eegan/albatross_fee/new-fee.kicad_pcb

## KiCad design new-fee.kicad_pcb (2023-12-21)

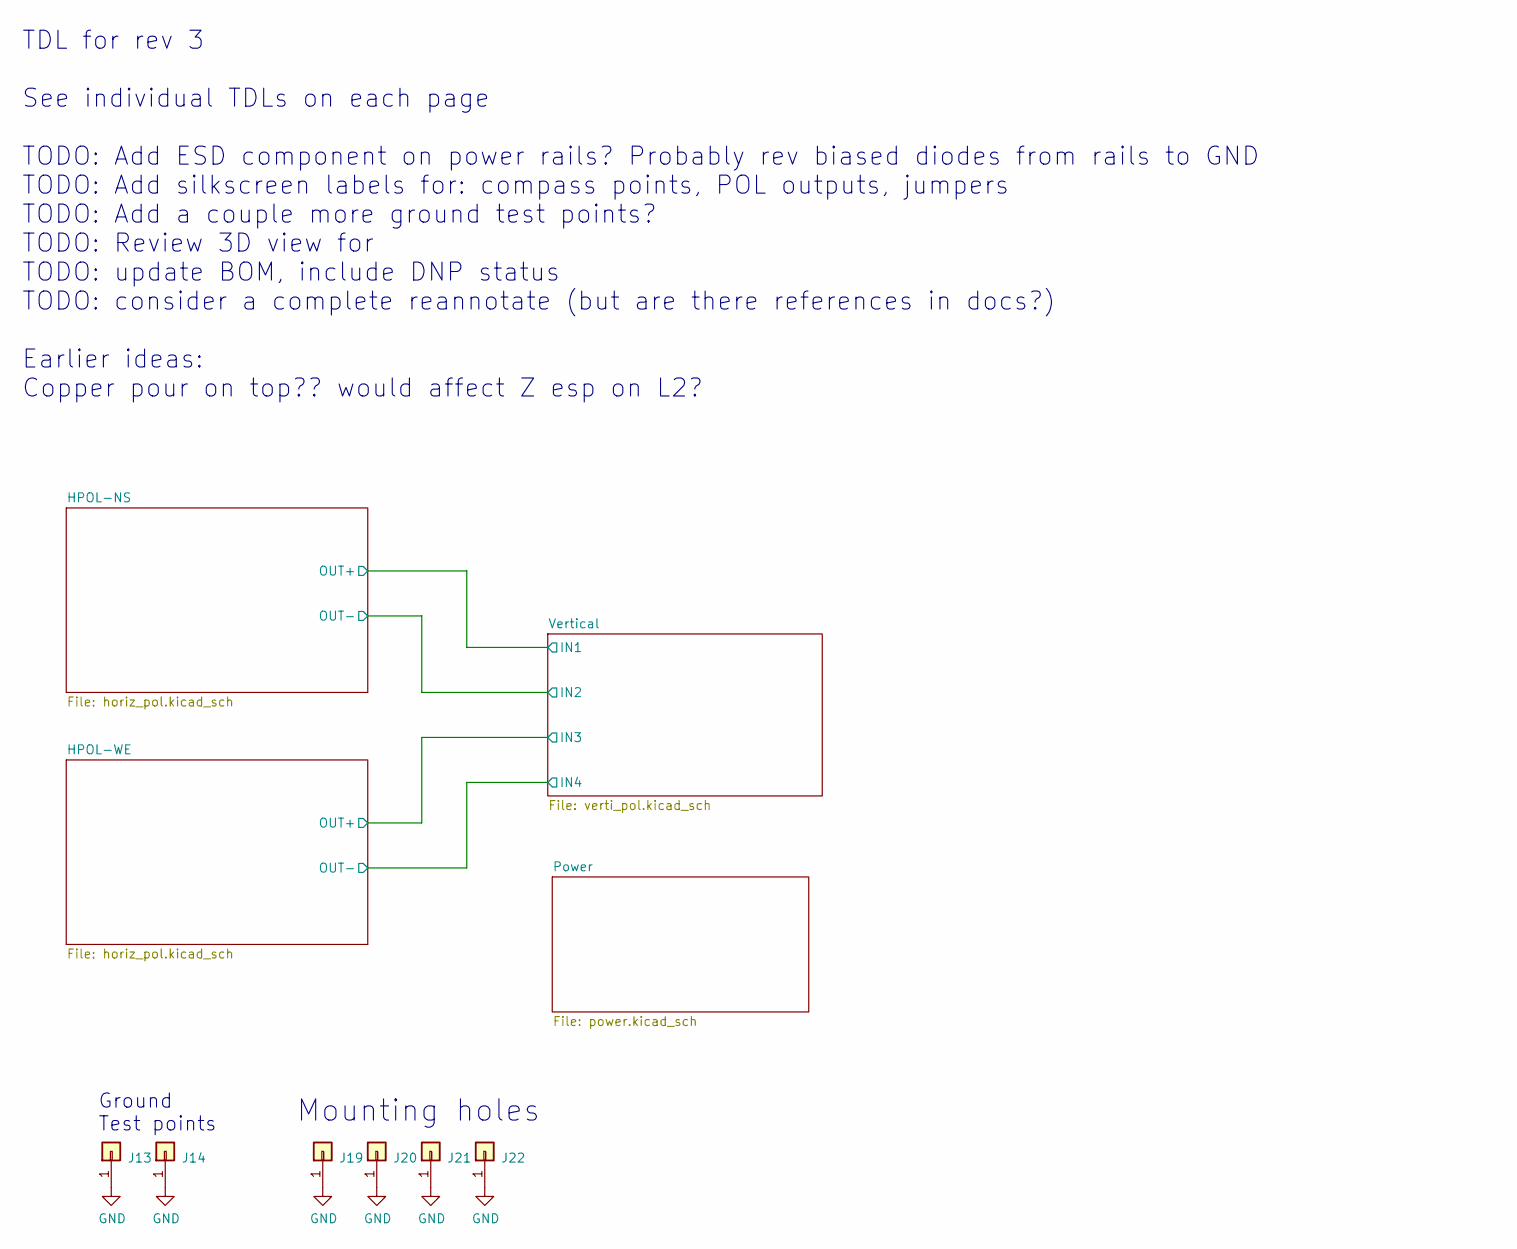
[picture p1: schematic new-fee.kicad_sch, ALBATROS low frequency front end]

Parts:
J13, J14: Conn_01x01; PinHeader_1x01_P2.54mm_Vertical
J19, J20, J21, J22: Conn_01x01; MountingHole_2.7mm_M2.5_Pad

Connections:
GND: J13.1, J14.1, J19.1, J20.1, J21.1, J22.1; also elsewhere on the board

Notes on the sheet:
Mounting holes
TDL for rev 3 See individual TDLs on each page TODO: Add ESD component on power rails? Probably rev biased diodes from rails to GND TODO: Add silkscreen labels for: compass points, POL outputs, jumpers TODO: Add a couple more ground test points? TODO: Review 3D view for TODO: update BOM, include DN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
Ground Test points

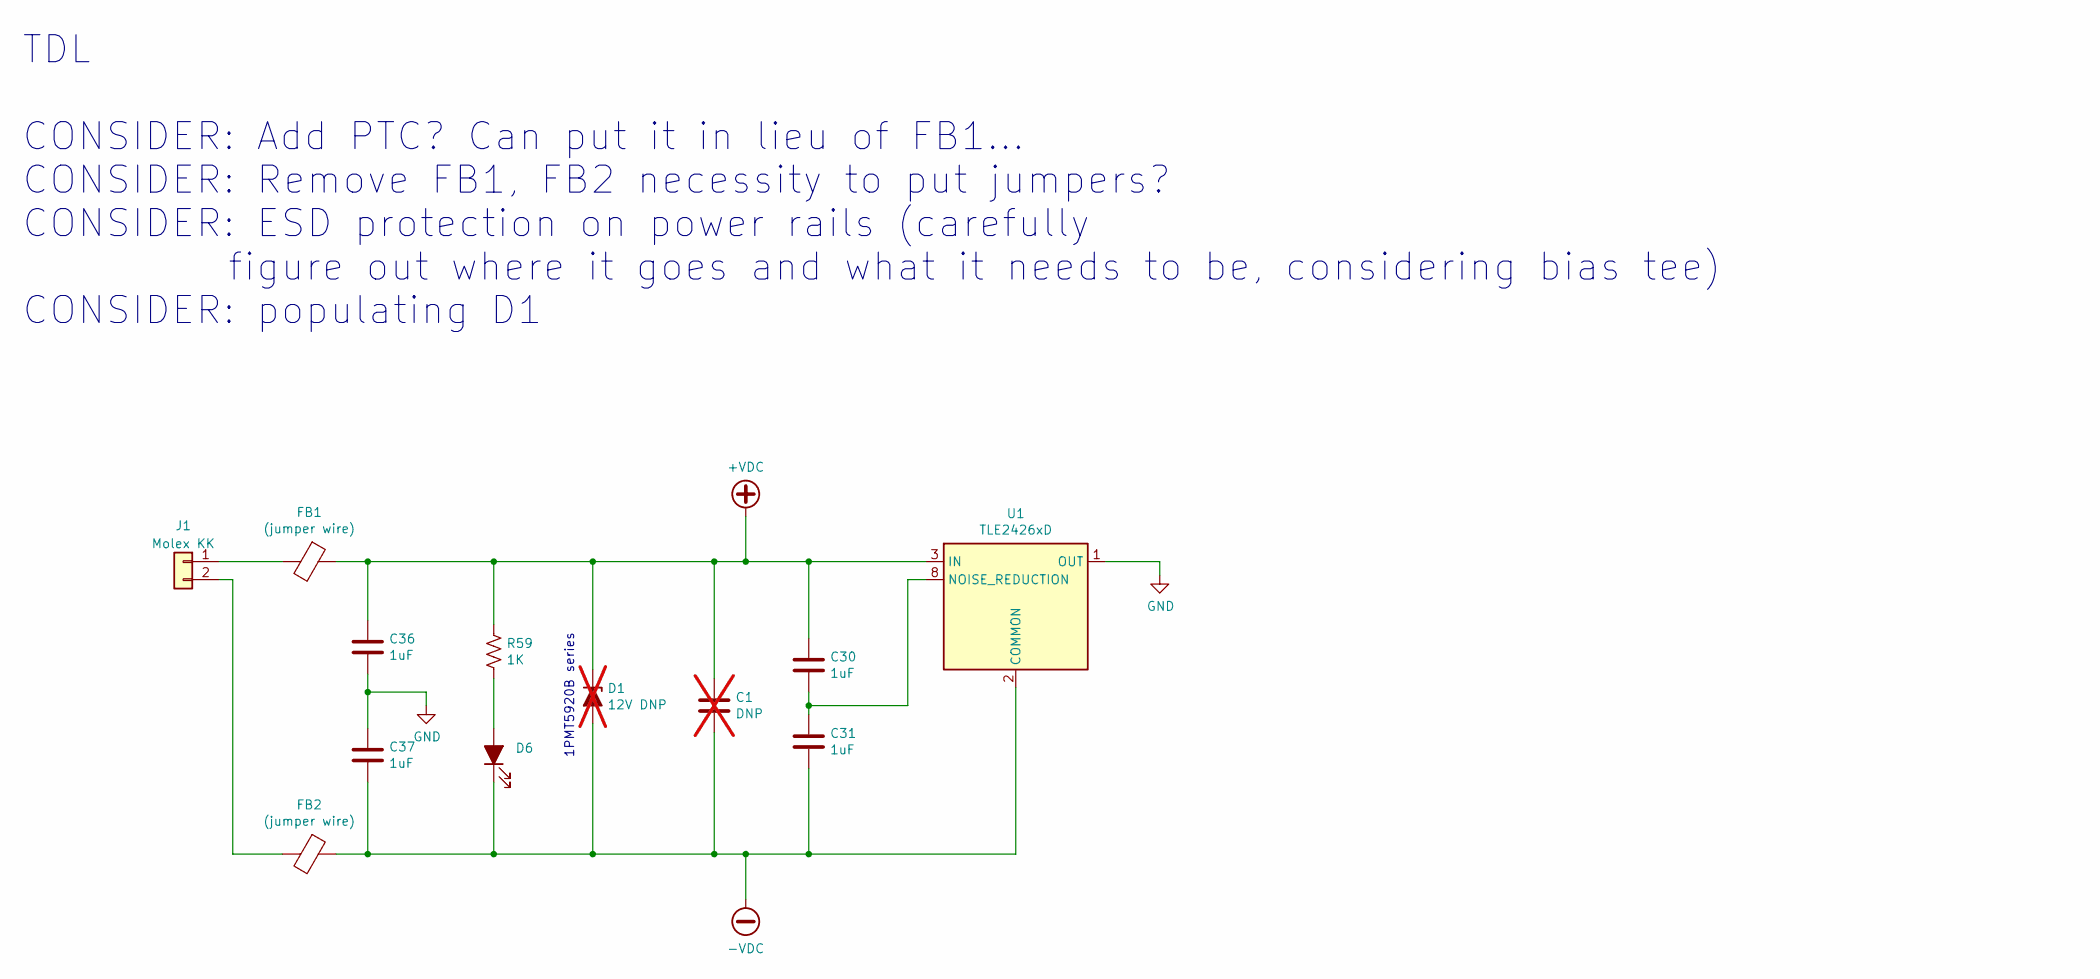
[picture p2: schematic power.kicad_sch, ALBATROS low frequency front end]

Parts:
C1: DNP; C_0603_1608Metric; not fitted
C30, C31, C36, C37: 1uF; C_0603_1608Metric; MPN CL10B105KA8NFNC
D1: 12V DNP; D_Powermite_AK; MPN 1PMT5927BT1G; not fitted
D6: LED_ALT; LED_0603_1608Metric; MPN 150060BS75000
FB1, FB2: (jumper wire); R_Axial_DIN0414_L11.9mm_D4.5mm_P25.40mm_Horizontal
J1: Molex KK; Molex_KK-254_AE-6410-02A_1x02_P2.54mm_Vertical; MPN 0022272021
R59: 1K; R_0603_1608Metric
U1: TLE2426xD; SOIC-8_3.9x4.9mm_P1.27mm; MPN TLE2426QDRG4Q1

Connections:
+VDC: C1.1, C30.1, C36.1, D1.1 (K), FB1.1, R59.1, U1.3 (IN); also elsewhere on the board
-VDC: C1.2, C31.2, C37.2, D1.2 (A), D6.1 (K), FB2.1, U1.2 (COMMON); also elsewhere on the board
GND: C36.2, C37.1, U1.1 (OUT); also elsewhere on the board
unnamed: D6.2 (A), R59.2
unnamed: FB1.2, J1.1
unnamed: FB2.2, J1.2
unnamed: C30.2, C31.1, U1.8 (NOISE_REDUCTION)

Notes on the sheet:
TDL CONSIDER: Add PTC? Can put it in lieu of FB1... CONSIDER: Remove FB1, FB2 necessity to put jumpers? CONSIDER: ESD protection on power rails (carefully figure out where it goes and what it needs to be, considering bias tee) CONSIDER: populating D1
1PMT5920B series

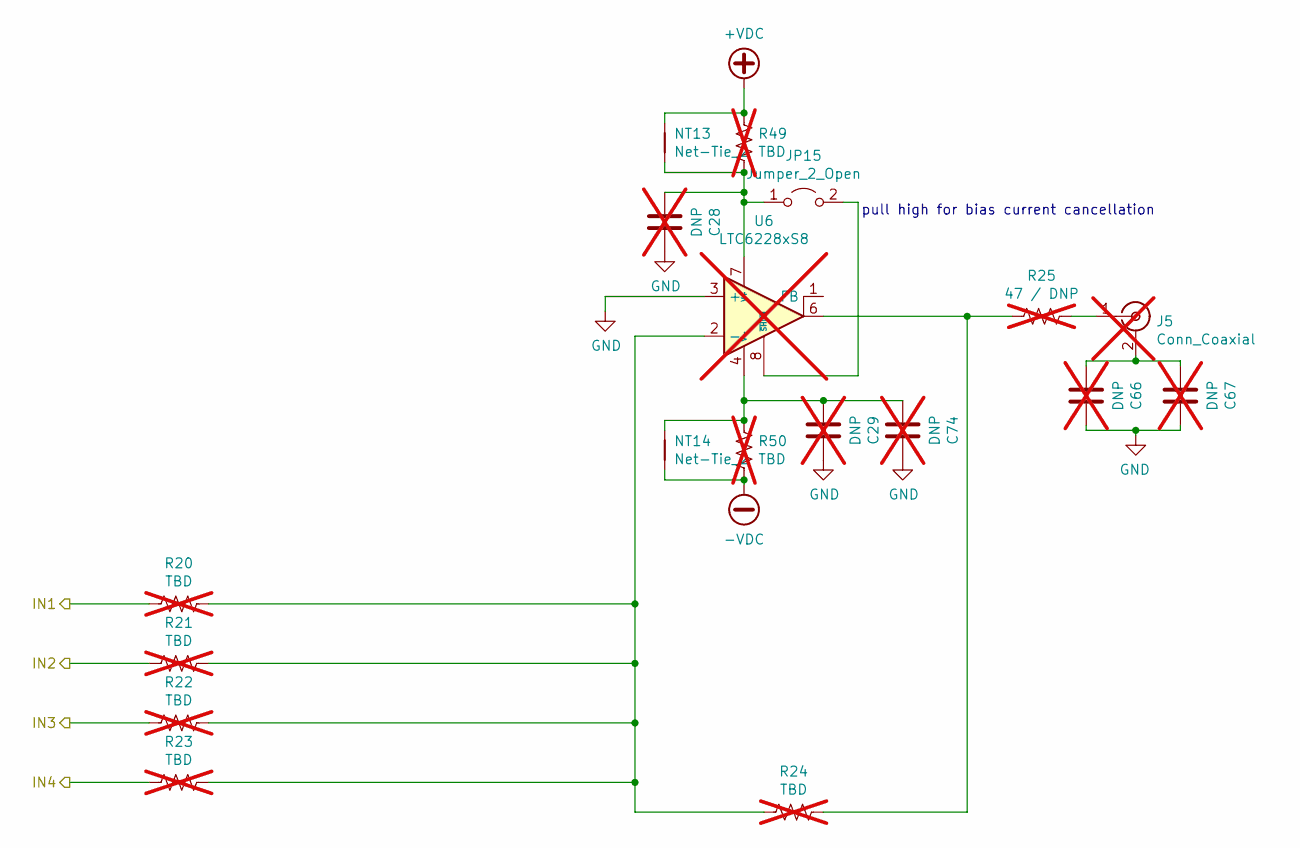
[picture p3: schematic verti_pol.kicad_sch, ALBATROS low frequency front end]

Parts:
C28, C29, C66, C67, C74: DNP; C_0603_1608Metric; not fitted
J5: Conn_Coaxial; SMA_Amphenol_901-144_Vertical; MPN 5-1814832-2; not fitted
JP15: Jumper_2_Open; SolderJumper-2_P1.3mm_Open_TrianglePad1.0x1.5mm
NT13, NT14: Net-Tie_2; NetTie-2_SMD_Pad0.5mm
R20, R21, R22, R23, R24, R49, R50: TBD; R_0603_1608Metric; not fitted
R25: 47 / DNP; R_0603_1608Metric; not fitted
U6: LTC6228xS8; SO-8_3.9x4.9mm_P1.27mm; not fitted

Connections:
+VDC: NT13.1, R49.2; also elsewhere on the board
-VDC: NT14.2, R50.1; also elsewhere on the board
/HPOL-NS/OUT+: R20.2; also elsewhere on the board
/HPOL-NS/OUT-: R21.2; also elsewhere on the board
/HPOL-WE/OUT+: R22.2; also elsewhere on the board
/HPOL-WE/OUT-: R23.2; also elsewhere on the board
GND: C28.1, C29.1, C66.1, C67.1, C74.1, U6.3 (+); also elsewhere on the board
unnamed: C29.2, C74.2, NT14.1, R50.2, U6.4 (V-), U6.5 (V-)
unnamed: C66.2, C67.2, J5.2 (Ext)
unnamed: J5.1 (In), R25.1
unnamed: C28.2, JP15.1 (A), NT13.2, R49.1, U6.7 (V+)
unnamed: JP15.2 (B), U6.8 (~SHDN)
unnamed: R24.1, R25.2, U6.6
unnamed: R20.1, R21.1, R22.1, R23.1, R24.2, U6.2 (-)

Notes on the sheet:
pull high for bias current cancellation

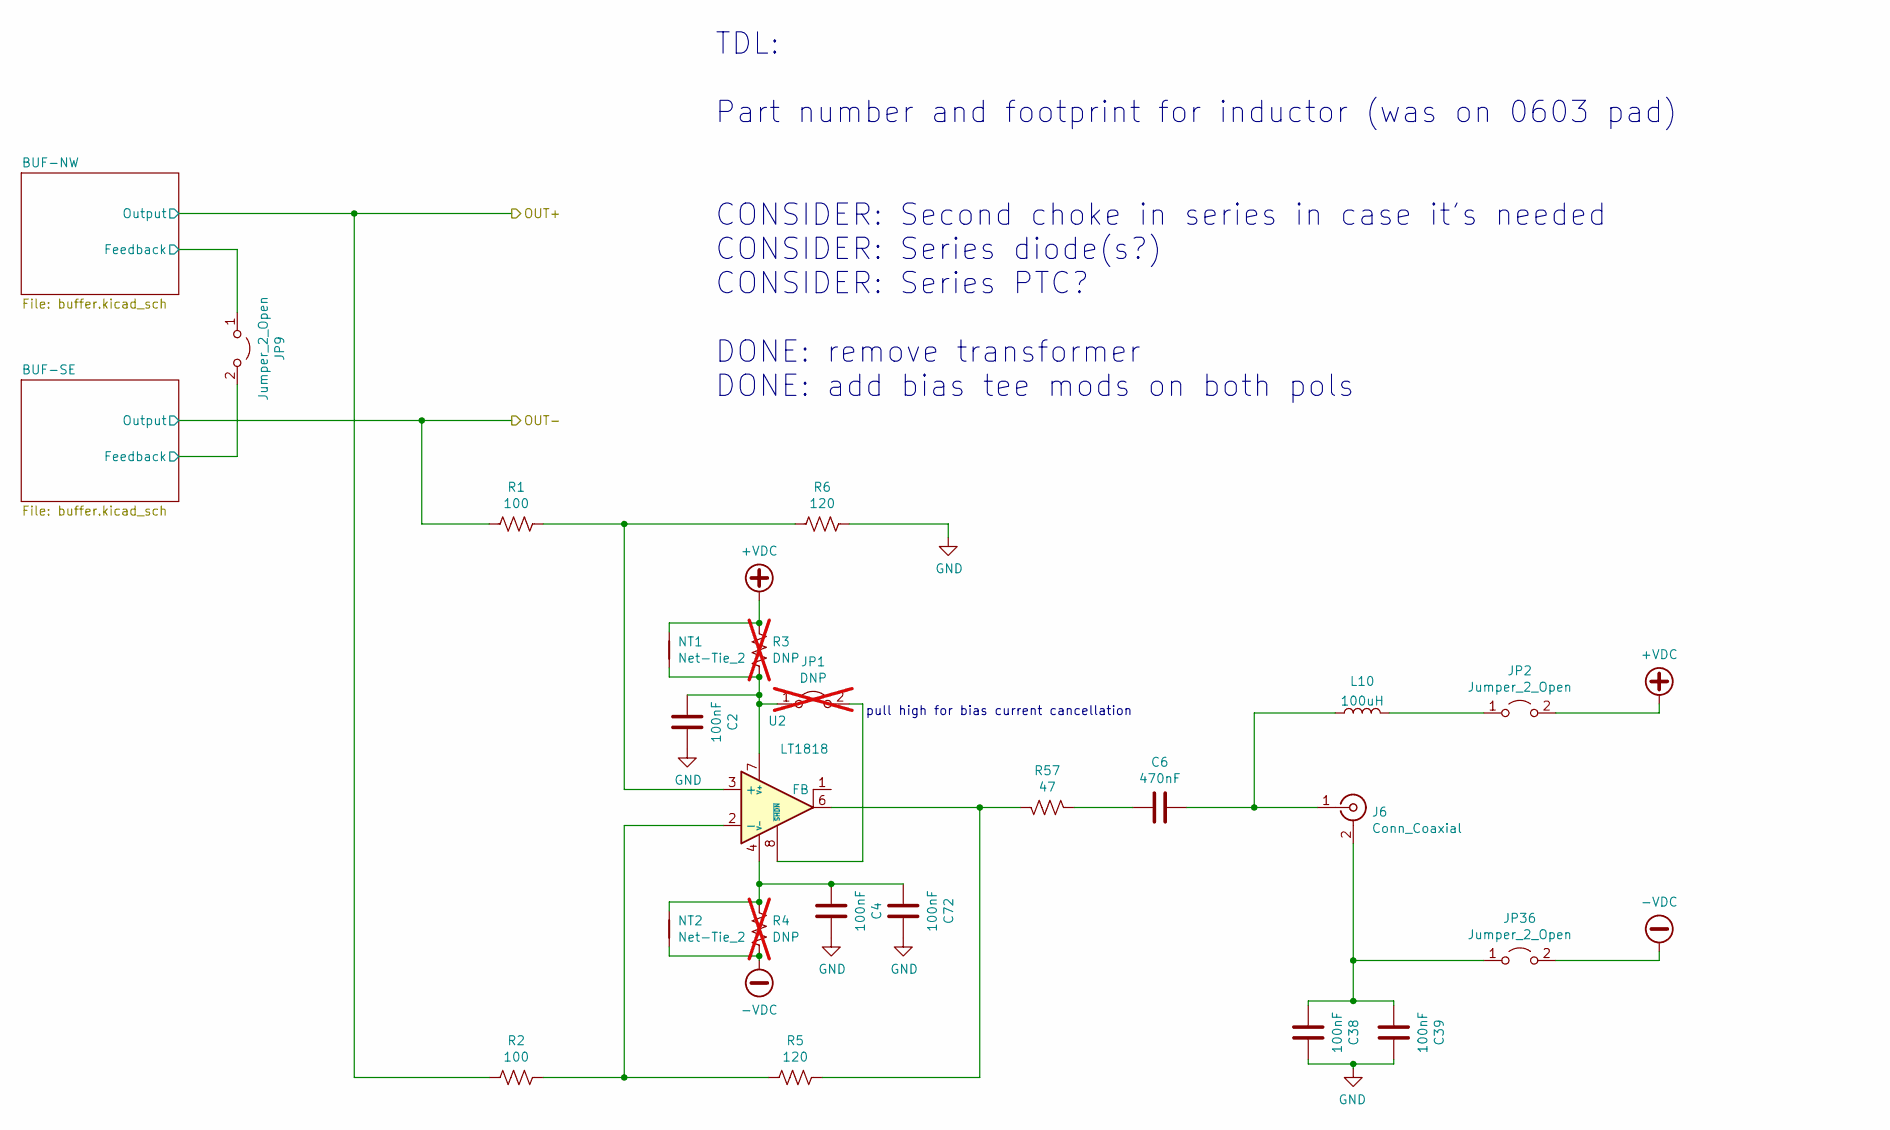
[picture p4: schematic horiz_pol.kicad_sch, ALBATROS low frequency front end]

Parts:
C2, C4, C38, C39, C72: 100nF; C_0603_1608Metric; MPN CL10B104KB8NNWC
C6: 470nF; C_0603_1608Metric; MPN CL10B474KA8NFNC
J6: Conn_Coaxial; SMA_Amphenol_901-144_Vertical; MPN 5-1814832-2
JP1: DNP; SolderJumper-2_P1.3mm_Open_TrianglePad1.0x1.5mm; not fitted
JP2, JP9, JP36: Jumper_2_Open; PinHeader_1x02_P2.54mm_Vertical
L10: 100uH; L_0603_1608Metric
NT1, NT2: Net-Tie_2; NetTie-2_SMD_Pad0.5mm
R1, R2: 100; R_0603_1608Metric
R3, R4: DNP; R_0603_1608Metric; not fitted
R5, R6: 120; R_0603_1608Metric
R57: 47; R_0603_1608Metric
U2: LT1818; SO-8_3.9x4.9mm_P1.27mm

Connections:
+VDC: JP2.2 (B), NT1.1, R3.2; also elsewhere on the board
-VDC: JP36.2 (B), NT2.2, R4.1; also elsewhere on the board
/HPOL-NS/BUF-NW/Feedback: JP9.1 (A); also elsewhere on the board
/HPOL-NS/BUF-SE/Feedback: JP9.2 (B); also elsewhere on the board
/HPOL-NS/OUT+: R2.2; also elsewhere on the board
/HPOL-NS/OUT-: R1.2; also elsewhere on the board
GND: C2.1, C4.1, C38.1, C39.1, C72.1, R6.1; also elsewhere on the board
unnamed: C4.2, C72.2, NT2.1, R4.2, U2.4 (V-), U2.5 (V-)
unnamed: C6.2, R57.2
unnamed: C38.2, C39.2, J6.2 (Ext), JP36.1 (A)
unnamed: C6.1, J6.1 (In), L10.1
unnamed: C2.2, JP1.1 (A), NT1.2, R3.1, U2.7 (V+)
unnamed: JP1.2 (B), U2.8 (~SHDN)
unnamed: JP2.1 (A), L10.2
unnamed: R5.1, R57.1, U2.6
unnamed: R1.1, R6.2, U2.3 (+)
unnamed: R2.1, R5.2, U2.2 (-)

Parts of its further copies:
C3: 470nF; C_0603_1608Metric; MPN CL10B474KA8NFNC
C5, C7, C52, C53, C73: 100nF; C_0603_1608Metric; MPN CL10B104KB8NNWC
J2: Conn_Coaxial; SMA_Amphenol_901-144_Vertical; MPN 5-1814832-2
JP3, JP21, JP37: Jumper_2_Open; PinHeader_1x02_P2.54mm_Vertical
JP4: DNP; SolderJumper-2_P1.3mm_Open_TrianglePad1.0x1.5mm; not fitted
L9: 100uH; L_0603_1608Metric
NT3, NT4: Net-Tie_2; NetTie-2_SMD_Pad0.5mm
R7, R8: 100; R_0603_1608Metric
R9, R10: DNP; R_0603_1608Metric; not fitted
R11, R12: 120; R_0603_1608Metric
R58: 47; R_0603_1608Metric
U3: LT1818; SO-8_3.9x4.9mm_P1.27mm

Connections of its further copies:
+VDC: JP3.2 (B), NT3.1, R9.2; also elsewhere on the board
-VDC: JP37.2 (B), NT4.2, R10.1; also elsewhere on the board
/HPOL-WE/BUF-NW/Feedback: JP21.1 (A); also elsewhere on the board
/HPOL-WE/BUF-SE/Feedback: JP21.2 (B); also elsewhere on the board
/HPOL-WE/OUT+: R8.2; also elsewhere on the board
/HPOL-WE/OUT-: R7.2; also elsewhere on the board
GND: C5.1, C7.1, C52.1, C53.1, C73.1, R12.1; also elsewhere on the board
unnamed: C3.2, R58.2
unnamed: C7.2, C73.2, NT4.1, R10.2, U3.4 (V-), U3.5 (V-)
unnamed: C52.2, C53.2, J2.2 (Ext), JP37.1 (A)
unnamed: C3.1, J2.1 (In), L9.1
unnamed: JP3.1 (A), L9.2
unnamed: C5.2, JP4.1 (A), NT3.2, R9.1, U3.7 (V+)
unnamed: JP4.2 (B), U3.8 (~SHDN)
unnamed: R11.1, R58.1, U3.6
unnamed: R7.1, R12.2, U3.3 (+)
unnamed: R8.1, R11.2, U3.2 (-)

Notes on the sheet:
TDL: Part number and footprint for inductor (was on 0603 pad) CONSIDER: Second choke in series in case it's needed CONSIDER: Series diode(s?) CONSIDER: Series PTC? DONE: remove transformer DONE: add bias tee mods on both pols
pull high for bias current cancellation

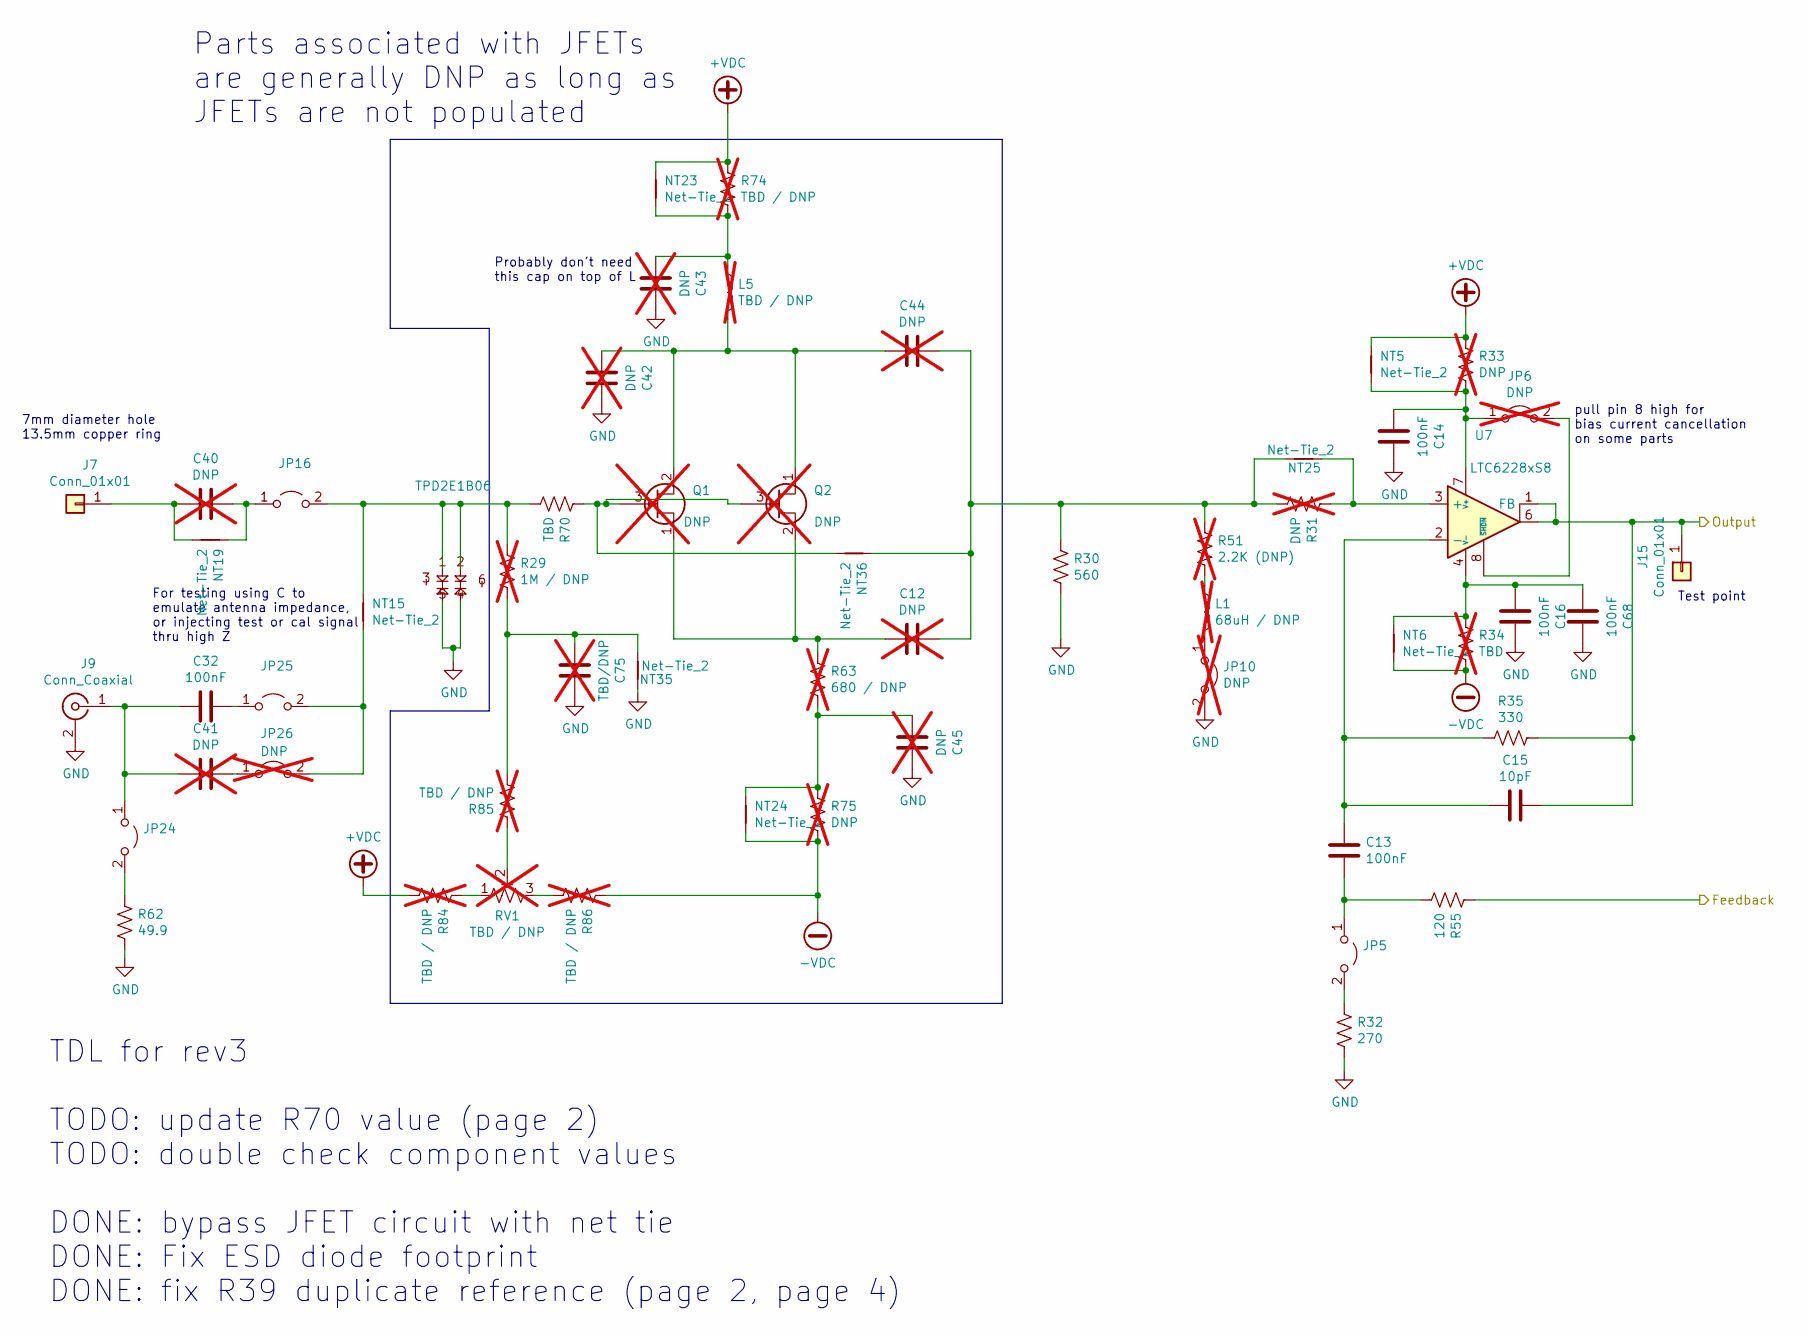
[picture p5: schematic buffer.kicad_sch, ALBATROS low frequency front end]

Parts:
C12, C40, C41, C42, C43, C44, C45: DNP; C_0603_1608Metric; not fitted
C13, C14, C16, C32, C68: 100nF; C_0603_1608Metric; MPN CL10B104KB8NNWC
C15: 10pF; C_0603_1608Metric; MPN CL10C100JB8NNNC
C75: TBD/DNP; C_0603_1608Metric; not fitted
D2: TPD2E1B06; SOT-563; MPN TPD2E1B06DRLR
J7: Conn_01x01; MountingHole_7.5mm
J9: Conn_Coaxial; SMA_Amphenol_132289_EdgeMount; MPN CONSMA020.062-G
J15: Conn_01x01; PinHeader_1x01_P2.54mm_Vertical
JP5, JP16, JP24, JP25: Jumper_2_Open; PinHeader_1x02_P2.54mm_Vertical
JP6: DNP; SolderJumper-2_P1.3mm_Open_TrianglePad1.0x1.5mm; not fitted
JP10, JP26: DNP; PinHeader_1x02_P2.54mm_Vertical; not fitted
L1: 68uH / DNP; L_Axial_L6.6mm_D2.7mm_P2.54mm_Vertical_Vishay_IM-2; not fitted
L5: TBD / DNP; L_0603_1608Metric; not fitted
NT5, NT6, NT15, NT19, NT23, NT24, NT25, NT35, NT36: Net-Tie_2; NetTie-2_SMD_Pad0.5mm
Q1, Q2: DNP; SOT-23; not fitted
R29: 1M / DNP; R_0603_1608Metric; not fitted
R30: 560; R_0603_1608Metric
R31, R33, R75: DNP; R_0603_1608Metric; not fitted
R32: 270; R_0603_1608Metric
R34: TBD; R_0603_1608Metric; not fitted
R35: 330; R_0603_1608Metric
R51: 2.2K (DNP); R_0603_1608Metric; not fitted
R55: 120; R_0603_1608Metric
R62: 49.9; R_0603_1608Metric
R63: 680 / DNP; R_0603_1608Metric; not fitted
R70: TBD; R_0603_1608Metric
R74, R84, R85, R86: TBD / DNP; R_0603_1608Metric; not fitted
RV1: TBD / DNP; Potentiometer_Bourns_3386C_Horizontal; not fitted
U7: LTC6228xS8; SO-8_3.9x4.9mm_P1.27mm

Connections:
+VDC: NT5.1, NT23.1, R33.2, R74.2, R84.1; also elsewhere on the board
-VDC: NT6.2, NT24.2, R34.1, R75.1, R86.2; also elsewhere on the board
/HPOL-NS/BUF-NW/Feedback: R55.2; also elsewhere on the board
/HPOL-NS/OUT+: C15.1, J15.1, R35.1, U7.1 (FB), U7.6; also elsewhere on the board
GND: C14.1, C16.1, C42.1, C43.1, C45.1, C68.1, C75.1, D2.4, D2.5, J9.2 (Ext), JP10.2 (B), NT35.1, R30.1, R32.1, R62.1; also elsewhere on the board
unnamed: C12.1, C44.1, NT25.2, NT36.1, R30.2, R31.1, R51.2
unnamed: C16.2, C68.2, NT6.1, R34.2, U7.4 (V-), U7.5 (V-)
unnamed: C43.2, L5.1, NT23.2, R74.1
unnamed: C45.2, NT24.1, R63.1, R75.2
unnamed: C75.2, NT35.2, R29.1, R85.1
unnamed: C40.2, J7.1, NT19.2
unnamed: C32.2, C41.2, J9.1 (In), JP24.1 (A)
unnamed: C13.1, JP5.1 (A), R55.1
unnamed: JP5.2 (B), R32.2
unnamed: C14.2, JP6.1 (A), NT5.2, R33.1, U7.7 (V+)
unnamed: JP6.2 (B), U7.8 (~SHDN)
unnamed: JP10.1 (A), L1.2
unnamed: C40.1, JP16.1 (A), NT19.1
unnamed: D2.1, D2.2, JP16.2 (B), NT15.1, R29.2, R70.1
unnamed: JP24.2 (B), R62.2
unnamed: C32.1, JP25.1 (A)
unnamed: JP25.2 (B), JP26.2 (B), NT15.2
unnamed: C41.1, JP26.1 (A)
unnamed: L1.1, R51.1
unnamed: C42.2, C44.2, L5.2, Q1.2 (D), Q2.1 (D)
unnamed: NT36.2, Q1.3 (G), Q2.3 (G), R70.2
unnamed: C12.2, Q1.1 (S), Q2.2 (S), R63.2
unnamed: R84.2, RV1.1
unnamed: R85.2, RV1.2
unnamed: R86.1, RV1.3
unnamed: NT25.1, R31.2, U7.3 (+)
unnamed: C13.2, C15.2, R35.2, U7.2 (-)

Parts of its further copies:
C8, C17, C23, C46, C47, C48, C49, C50, C51, C54, C55, C56, C57, C58, C59, C60, C61, C62, C63, C64, C65: DNP; C_0603_1608Metric; not fitted
C9, C10, C18, C19, C21, C22, C24, C25, C27, C33, C34, C35, C69, C70, C71: 100nF; C_0603_1608Metric; MPN CL10B104KB8NNWC
C11, C20, C26: 10pF; C_0603_1608Metric; MPN CL10C100JB8NNNC
C76, C77, C78: TBD/DNP; C_0603_1608Metric; not fitted
D3, D4, D5: TPD2E1B06; SOT-563; MPN TPD2E1B06DRLR
J3, J4, J8: Conn_01x01; MountingHole_7.5mm
J10, J11, J12: Conn_Coaxial; SMA_Amphenol_132289_EdgeMount; MPN CONSMA020.062-G
J16, J17, J18: Conn_01x01; PinHeader_1x01_P2.54mm_Vertical
JP7, JP11, JP13, JP17, JP18, JP19, JP27, JP28, JP30, JP31, JP33, JP34: Jumper_2_Open; PinHeader_1x02_P2.54mm_Vertical
JP8, JP12, JP14: DNP; SolderJumper-2_P1.3mm_Open_TrianglePad1.0x1.5mm; not fitted
JP20, JP22, JP23, JP29, JP32, JP35: DNP; PinHeader_1x02_P2.54mm_Vertical; not fitted
L2, L3, L4: 68uH / DNP; L_Axial_L6.6mm_D2.7mm_P2.54mm_Vertical_Vishay_IM-2; not fitted
L6, L7, L8: TBD / DNP; L_0603_1608Metric; not fitted
NT7, NT8, NT9, NT10, NT11, NT12, NT16, NT17, NT18, NT20, NT21, NT22, NT26, NT27, NT28, NT29, NT30, NT31, NT32, NT33, NT34, NT37, NT38, NT39, NT40, NT41, NT42: Net-Tie_2; NetTie-2_SMD_Pad0.5mm
Q3, Q4, Q5, Q6, Q7, Q8: DNP; SOT-23; not fitted
R14, R27, R37: 1M / DNP; R_0603_1608Metric; not fitted
R15, R36, R38: 560; R_0603_1608Metric
R16, R18, R39, R41, R44, R46, R77, R79, R81: DNP; R_0603_1608Metric; not fitted
R17, R40, R45: 270; R_0603_1608Metric
R19, R42, R47: TBD; R_0603_1608Metric; not fitted
R26, R43, R48: 330; R_0603_1608Metric
R52, R53, R54: 2.2K (DNP); R_0603_1608Metric; not fitted
R56, R82, R83: 120; R_0603_1608Metric
R64, R66, R68: 49.9; R_0603_1608Metric
R65, R67, R69: 680 / DNP; R_0603_1608Metric; not fitted
R71, R72, R73: TBD; R_0603_1608Metric
R76, R78, R80, R87, R88, R89, R90, R91, R92, R93, R94, R95: TBD / DNP; R_0603_1608Metric; not fitted
RV2, RV3, RV4: TBD / DNP; Potentiometer_Bourns_3386C_Horizontal; not fitted
U4, U5, U8: LTC6228xS8; SO-8_3.9x4.9mm_P1.27mm

Connections of its further copies:
+VDC: NT7.1, NT9.1, NT11.1, NT26.1, NT29.1, NT32.1, R18.2, R41.2, R46.2, R76.2, R78.2, R80.2, R87.1, R90.1, R93.1; also elsewhere on the board
-VDC: NT8.2, NT10.2, NT12.2, NT27.2, NT30.2, NT33.2, R19.1, R42.1, R47.1, R77.1, R79.1, R81.1, R89.2, R92.2, R95.2; also elsewhere on the board
/HPOL-NS/BUF-SE/Feedback: R56.2; also elsewhere on the board
/HPOL-NS/OUT-: C20.1, J16.1, R43.1, U8.1 (FB), U8.6; also elsewhere on the board
/HPOL-WE/BUF-NW/Feedback: R82.2; also elsewhere on the board
/HPOL-WE/BUF-SE/Feedback: R83.2; also elsewhere on the board
/HPOL-WE/OUT+: C11.1, J17.1, R26.1, U4.1 (FB), U4.6; also elsewhere on the board
/HPOL-WE/OUT-: C26.1, J18.1, R48.1, U5.1 (FB), U5.6; also elsewhere on the board
GND: C10.1, C19.1, C21.1, C22.1, C25.1, C27.1, C48.1, C49.1, C51.1, C56.1, C57.1, C59.1, C62.1, C63.1, C65.1, C69.1, C70.1, C71.1, C76.1, C77.1, C78.1, D3.4, D3.5, D4.4, D4.5, D5.4, D5.5, J10.2 (Ext), J11.2 (Ext), J12.2 (Ext), JP20.2 (B), JP22.2 (B), JP23.2 (B), NT37.1, NT39.1, NT41.1, R15.1, R17.1, R36.1, R38.1, R40.1, R45.1, R64.1, R66.1, R68.1; also elsewhere on the board
unnamed: C17.1, C50.1, NT28.2, NT40.1, R38.2, R39.1, R52.2
unnamed: C21.2, C69.2, NT8.1, R42.2, U8.4 (V-), U8.5 (V-)
unnamed: C22.2, C70.2, NT10.1, R19.2, U4.4 (V-), U4.5 (V-)
unnamed: C23.1, C64.1, NT34.2, NT42.1, R36.2, R44.1, R54.2
unnamed: C27.2, C71.2, NT12.1, R47.2, U5.4 (V-), U5.5 (V-)
unnamed: C49.2, L6.1, NT26.2, R76.1
unnamed: C51.2, NT27.1, R65.1, R77.2
unnamed: C57.2, L7.1, NT29.2, R78.1
unnamed: C8.1, C58.1, NT31.2, NT38.1, R15.2, R16.1, R53.2
unnamed: C59.2, NT30.1, R67.1, R79.2
unnamed: C63.2, L8.1, NT32.2, R80.1
unnamed: C65.2, NT33.1, R69.1, R81.2
unnamed: C76.2, NT37.2, R37.1, R88.1
unnamed: C77.2, NT39.2, R14.1, R91.1
unnamed: C78.2, NT41.2, R27.1, R94.1
unnamed: C54.2, J3.1, NT21.2
unnamed: C60.2, J4.1, NT22.2
unnamed: C46.2, J8.1, NT20.2
unnamed: C33.2, C47.2, J10.1 (In), JP27.1 (A)
unnamed: C34.2, C55.2, J11.1 (In), JP30.1 (A)
unnamed: C35.2, C61.2, J12.1 (In), JP33.1 (A)
unnamed: C18.1, JP7.1 (A), R56.1
unnamed: JP7.2 (B), R40.2
unnamed: C19.2, JP8.1 (A), NT7.2, R41.1, U8.7 (V+)
unnamed: JP8.2 (B), U8.8 (~SHDN)
unnamed: C9.1, JP11.1 (A), R82.1
unnamed: JP11.2 (B), R17.2
unnamed: C10.2, JP12.1 (A), NT9.2, R18.1, U4.7 (V+)
unnamed: JP12.2 (B), U4.8 (~SHDN)
unnamed: C24.1, JP13.1 (A), R83.1
unnamed: JP13.2 (B), R45.2
unnamed: C25.2, JP14.1 (A), NT11.2, R46.1, U5.7 (V+)
unnamed: JP14.2 (B), U5.8 (~SHDN)
unnamed: C46.1, JP17.1 (A), NT20.1
unnamed: D3.1, D3.2, JP17.2 (B), NT16.1, R37.2, R71.1
unnamed: C54.1, JP18.1 (A), NT21.1
unnamed: D4.1, D4.2, JP18.2 (B), NT17.1, R14.2, R72.1
unnamed: C60.1, JP19.1 (A), NT22.1
unnamed: D5.1, D5.2, JP19.2 (B), NT18.1, R27.2, R73.1
unnamed: JP20.1 (A), L2.2
unnamed: JP22.1 (A), L3.2
unnamed: JP23.1 (A), L4.2
unnamed: JP27.2 (B), R64.2
unnamed: C33.1, JP28.1 (A)
unnamed: JP28.2 (B), JP29.2 (B), NT16.2
unnamed: C47.1, JP29.1 (A)
unnamed: JP30.2 (B), R66.2
unnamed: C34.1, JP31.1 (A)
unnamed: JP31.2 (B), JP32.2 (B), NT17.2
unnamed: C55.1, JP32.1 (A)
unnamed: JP33.2 (B), R68.2
unnamed: C35.1, JP34.1 (A)
unnamed: JP34.2 (B), JP35.2 (B), NT18.2
unnamed: C61.1, JP35.1 (A)
unnamed: L2.1, R52.1
unnamed: L3.1, R53.1
unnamed: L4.1, R54.1
unnamed: C48.2, C50.2, L6.2, Q3.2 (D), Q4.1 (D)
unnamed: NT40.2, Q3.3 (G), Q4.3 (G), R71.2
unnamed: C17.2, Q3.1 (S), Q4.2 (S), R65.2
unnamed: C56.2, C58.2, L7.2, Q5.2 (D), Q6.1 (D)
unnamed: NT38.2, Q5.3 (G), Q6.3 (G), R72.2
unnamed: C8.2, Q5.1 (S), Q6.2 (S), R67.2
unnamed: C62.2, C64.2, L8.2, Q7.2 (D), Q8.1 (D)
unnamed: NT42.2, Q7.3 (G), Q8.3 (G), R73.2
unnamed: C23.2, Q7.1 (S), Q8.2 (S), R69.2
unnamed: R87.2, RV2.1
unnamed: R88.2, RV2.2
unnamed: R89.1, RV2.3
unnamed: R90.2, RV3.1
unnamed: R91.2, RV3.2
unnamed: R92.1, RV3.3
unnamed: R93.2, RV4.1
unnamed: R94.2, RV4.2
unnamed: R95.1, RV4.3
unnamed: NT31.1, R16.2, U4.3 (+)
unnamed: C9.2, C11.2, R26.2, U4.2 (-)
unnamed: NT34.1, R44.2, U5.3 (+)
unnamed: C24.2, C26.2, R48.2, U5.2 (-)
unnamed: NT28.1, R39.2, U8.3 (+)
unnamed: C18.2, C20.2, R43.2, U8.2 (-)

Notes on the sheet:
Test point
Parts associated with JFETs are generally DNP as long as JFETs are not populated
TDL for rev3 TODO: update R70 value (page 2) TODO: double check component values DONE: bypass JFET circuit with net tie DONE: Fix ESD diode footprint DONE: fix R39 duplicate reference (page 2, page 4)
pull pin 8 high for bias current cancellation on some parts
For testing using C to emulate antenna impedance, or injecting test or cal signal thru high Z
Probably don't need this cap on top of L
7mm diameter hole 13.5mm copper ring

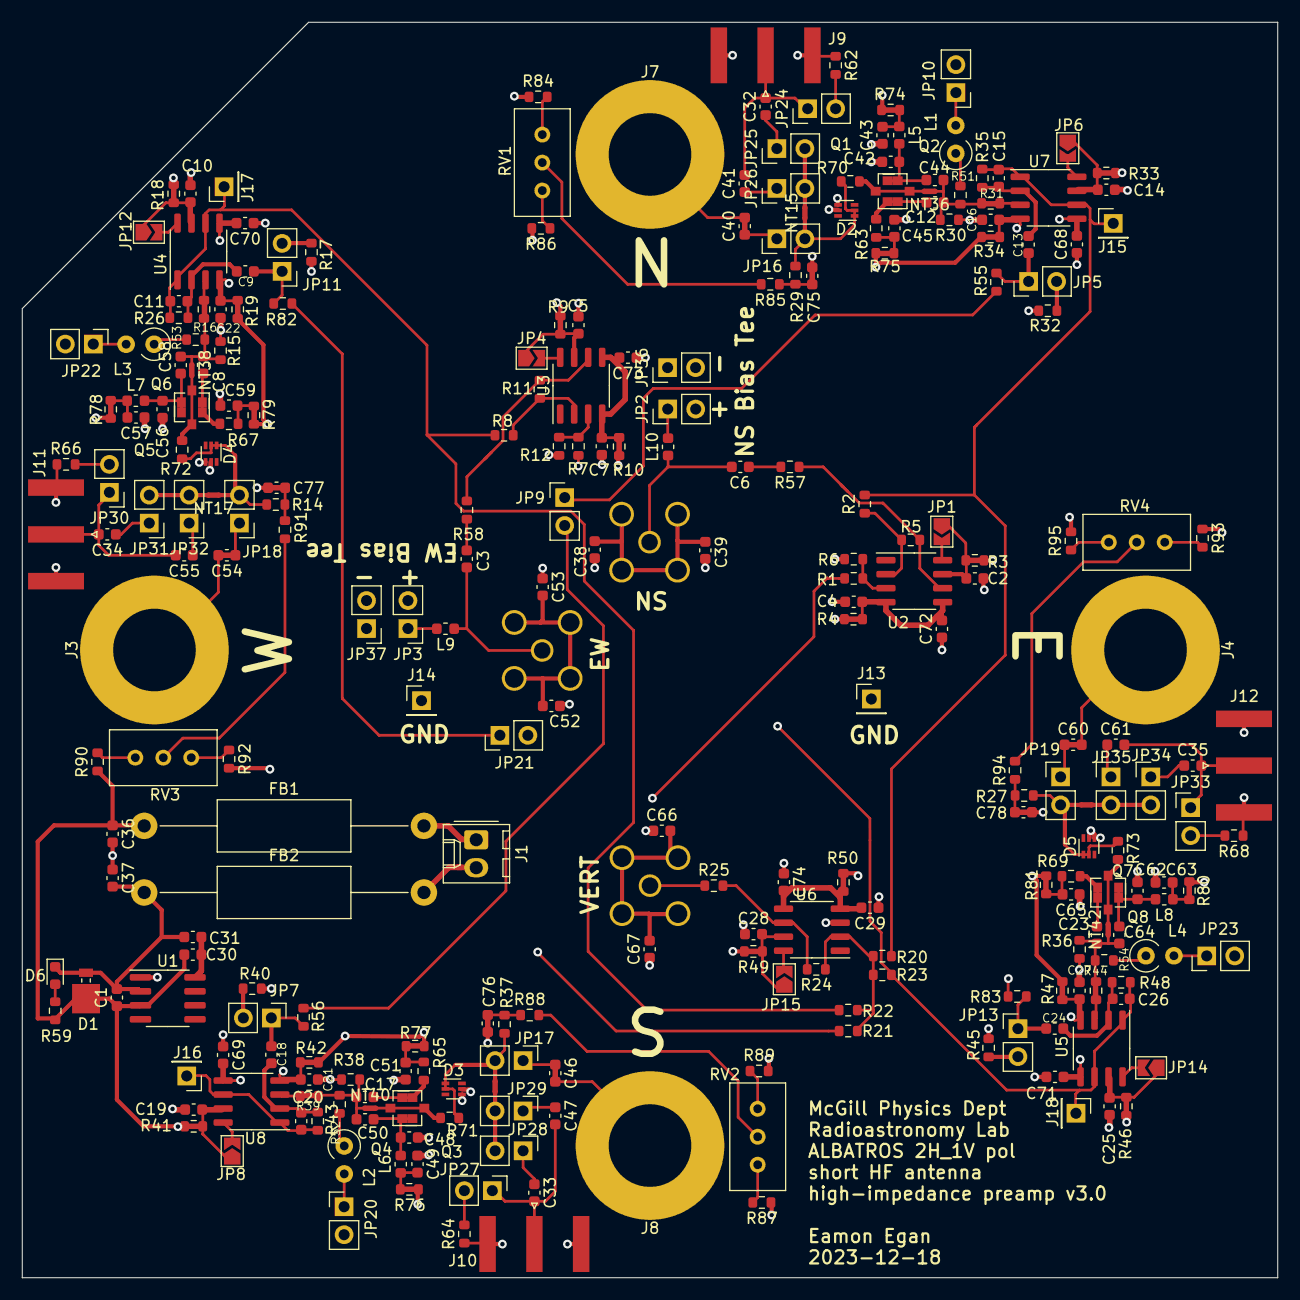
[picture p6: board new-fee.kicad_pcb from above]

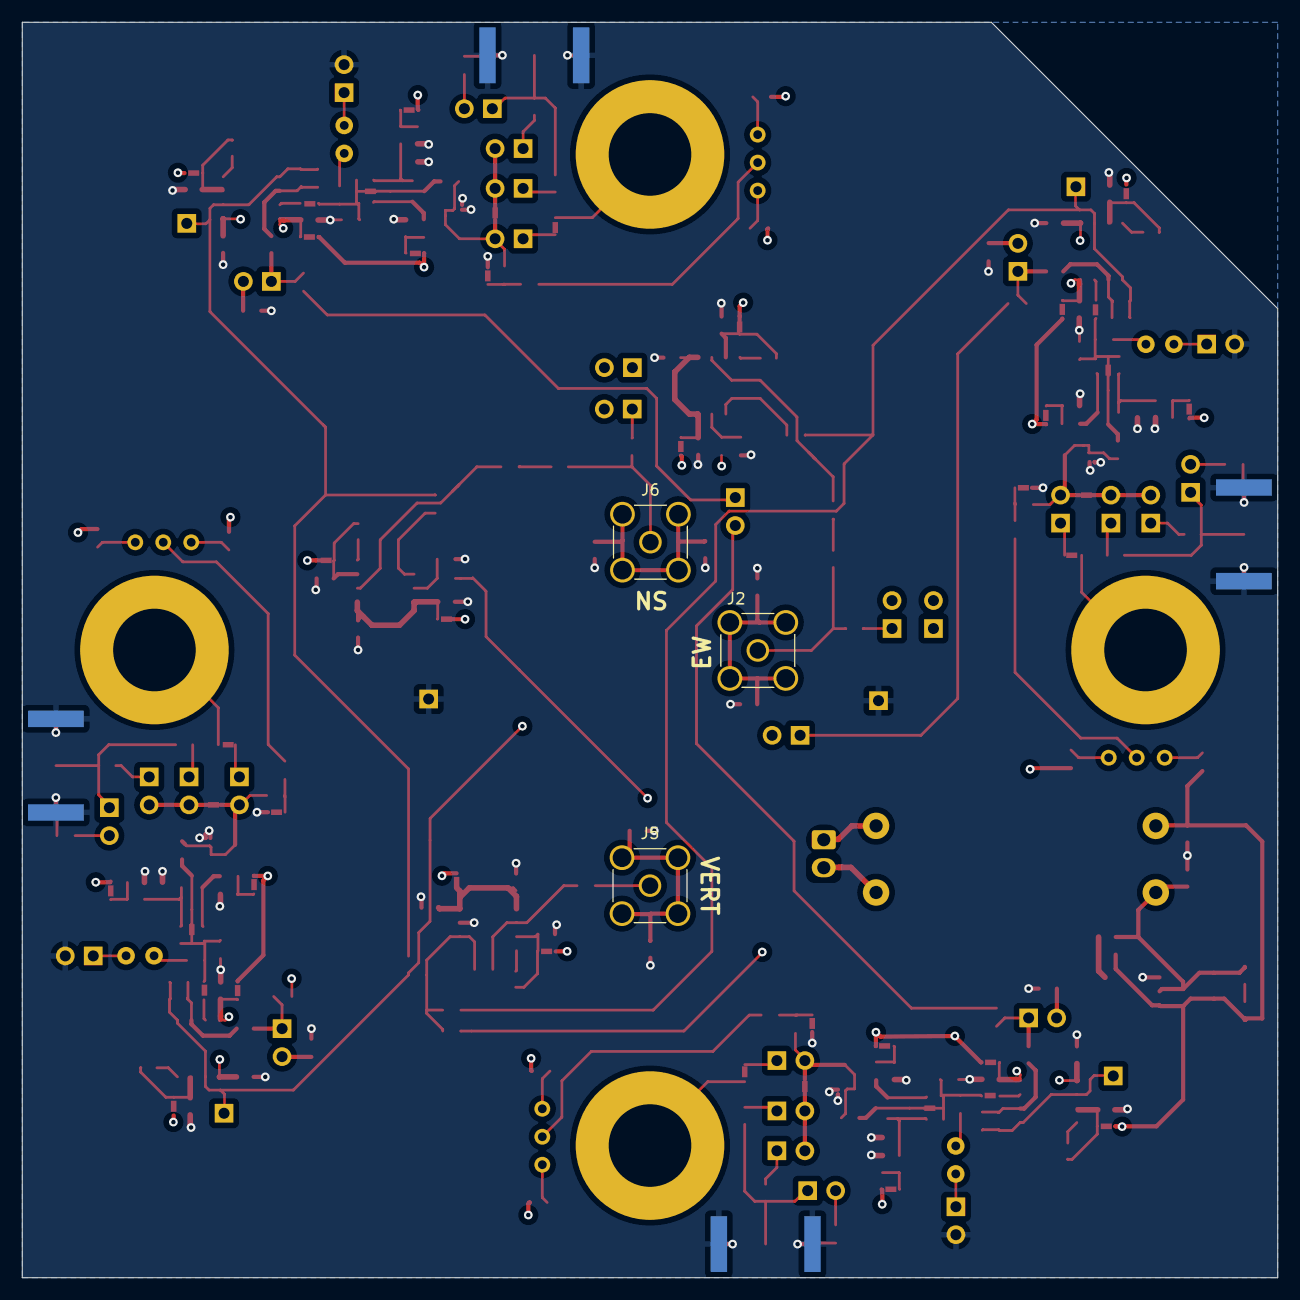
[picture p7: board new-fee.kicad_pcb from below]

Board: 4 copper layers, 114.0 x 114.0 mm, 304 parts (3 on the bottom side), 150 nets.
