eegan/albatross_fee/(commit log)

2021-05-15 Initial commit - of initial sketch
    [new-fee.kicad_pcb, new-fee.sch]
2021-05-16 Complete rough structure and most aspects of schematic level design
    [buffer.sch, horiz_pol.sch, new-fee.sch, power.sch, verti_pol.sch]
2021-05-16 Add input AM BCB filter
    [buffer.sch, horiz_pol.sch]
2021-05-16 annotate; connect feedback pins
    [buffer.sch, horiz_pol.sch]
2021-05-16 Add board outline with locations of holes
    [buffer.sch, new-fee.kicad_pcb]
2021-05-16 Add most footprints for size trial (looking at parts on PCB)
    [buffer.sch, horiz_pol.sch, power.sch, verti_pol.sch]
2021-05-17 Add footprints (not necessarily final)
    [buffer.sch, horiz_pol.sch, power.sch, verti_pol.sch]
2021-05-17 Place and route buffer section
    [buffer.sch, horiz_pol.sch, new-fee.kicad_pcb]
2021-05-18 trial use of replicate layout
    [new-fee.kicad_pcb]
2021-05-18 Add jumpers, make them pin jumpers
    [buffer.sch, horiz_pol.sch, new-fee.kicad_pcb]
2021-05-18 Finish routing h-pol, before trying to duplicate layout and see if there are shorts
    [new-fee.kicad_pcb]
2021-05-19 Routing all done
    [buffer.sch, horiz_pol.sch, new-fee.kicad_pcb, new-fee.sch, power.sch]
2021-05-21 Test points added at output of each leg preamp. Mounting holes added. As ordered v1.0b
    [buffer.sch, horiz_pol.sch, new-fee.kicad_pcb, new-fee.sch]
2021-11-03 Stuff as found in the folder before starting rev2. I guess I didn't commit them earlier
    [buffer.sch, horiz_pol.sch, new-fee.kicad_pcb, new-fee.sch, power.sch, verti_pol.sch]
2021-11-04 1st stage schematic change: Add 50Ω termination with jumper at SMA Add 2 capacitors with jumpers between SMA and input Add capacitor and jumper between antenna and input Add JFET (two pinouts, with t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
    [buffer.sch, horiz_pol.sch, new-fee.sch, power.sch, verti_pol.sch]
2021-11-04 Float the horizontal pol SMA ground Mostly notes and minor edits on Buffer.sch
    [buffer.sch, horiz_pol.sch]
2021-11-05 horiz_pol, verti-pol: Add coupling capacitors on output buffer: mostly text changes pcb: new buffer ckt pretty much routed, before some changes to feedback pin etc
    [buffer.sch, horiz_pol.sch, new-fee.kicad_pcb, verti_pol.sch]
2021-11-05 Prior to testing replicate layout Connected FB pin Changed block names to indicate compass points Tore up nets we're going to route on internal layers
    [buffer.sch, horiz_pol.sch, new-fee.kicad_pcb, new-fee.sch]
2021-11-06 inter-block routing and power traces deleted board setup changed to 4 layers prior to replicate layout step (for real this time)
    [new-fee.kicad_pcb]
2021-11-06 a bit more trace cleanup see zero-pad nets, going to update from sch or try other things
    [new-fee.kicad_pcb]
2021-11-11 Fully routed still need to adjust hole location, add back mounting holes and text
    [buffer.sch, horiz_pol.sch, new-fee.kicad_pcb, verti_pol.sch]
2021-11-19 Add TDL notes
    [new-fee.sch]
2021-11-22 Add bias pot, adjust antenna hole diameter and position (make them exactly 90mm apart)
    [buffer.sch, new-fee.kicad_pcb]
2021-11-24 Rev 2 PCBs as ordered (fee_v2a_gerber.zip)
    [buffer.sch, new-fee.kicad_pcb, new-fee.sch]
2022-06-14 Commit KiCAD 6.0 versions of all the files No substantive changes thought to have been made Also committed eco.txt, .gitignore with a few more extensions
    [buffer.kicad_sch, horiz_pol.kicad_sch, new-fee.kicad_pcb, new-fee.kicad_sch, power.kicad_sch, verti_pol.kicad_sch]
2022-06-27 Update components to as-built state. Add graphic lines to show bias tee mod.
    [buffer.kicad_sch, horiz_pol.kicad_sch, new-fee.kicad_sch, power.kicad_sch]
2023-12-18 mostly git 6 to git 7?, some text cleaned up?
    [buffer.kicad_sch, horiz_pol.kicad_sch, new-fee.kicad_sch, power.kicad_sch, verti_pol.kicad_sch]
2023-12-18 update schematic drawing control block
    [buffer.kicad_sch, horiz_pol.kicad_sch, new-fee.kicad_sch, power.kicad_sch, verti_pol.kicad_sch]
2023-12-18 change rev 1 to 2 in title block
    [buffer.kicad_sch, horiz_pol.kicad_sch, new-fee.kicad_sch, power.kicad_sch, verti_pol.kicad_sch]
2023-12-18 make schematic changes for most TODO items; update TDL
    [buffer.kicad_sch, horiz_pol.kicad_sch, new-fee.kicad_sch]
2023-12-18 fix duplicate resistor name R55 was wrongly changed to R39??; complete schematic annotation
    [buffer.kicad_sch, horiz_pol.kicad_sch]
2023-12-18 minor sch edits prior to implementing changes; implement changes on pcb
    [horiz_pol.kicad_sch, new-fee.kicad_pcb, new-fee.kicad_sch]
2023-12-18 deleted v5 schematic files
    [buffer.sch, horiz_pol.sch, new-fee.sch, power.sch, verti_pol.sch]
2023-12-20 DRC errors checked, trace clearance lowered from 0.2mm to 0.15mm
    [new-fee.kicad_pcb]
2023-12-21 Add DNP designations to parts on schematic. Add silkscreen text indications on PCB. Fix some, check other DRC errors.
    [buffer.kicad_sch, horiz_pol.kicad_sch, new-fee.kicad_pcb, power.kicad_sch, verti_pol.kicad_sch]
2023-12-21 Populate parts list. Change power connector to proper Molex footprint.
    [buffer.kicad_sch, horiz_pol.kicad_sch, new-fee.kicad_pcb, new-fee.kicad_sch, power.kicad_sch, verti_pol.kicad_sch]
2024-01-18 bom field completions
    [buffer.kicad_sch, horiz_pol.kicad_sch, new-fee.kicad_sch, power.kicad_sch, verti_pol.kicad_sch]
2024-01-18 a few parts attribute changes
    [buffer.kicad_sch, power.kicad_sch]
